Sujalshadow11/R-AV-Line-Follower-Robot/README.md

# R&AV LINE FOLLOWER ROBOT

> A High-Performance, Memory-Enabled, Path-Optimizing Autonomous Robotics Platform

---

# Overview

This repository documents my three-year engineering journey in designing and developing advanced Line Following Robots (LFRs), beginning from a simple beginner-level robot and evolving into a fully modular, memory-enabled, shortest-path-optimizing autonomous navigation platform.

The project progressively expanded across multiple engineering domains including:

- Embedded Systems
- PID Control Systems
- Autonomous Navigation
- Sensor Engineering
- PCB Design
- Runtime Configurable Interfaces
- EEPROM-Based Memory Systems
- High-Speed Robotics
- Custom Sensor Array Development

---

# Development Timeline

### YEAR 1 — Foundations of Reactive Robotics

- Basic IF-ELSE line following
- Sensor expansion experiments
- Mechanical calibration systems
- Drive system optimization

### YEAR 2 — Precision Control & Embedded Systems

- PID-based motion control
- Custom PCB development
- High-speed navigation
- Hybrid sensor architectures
- Competition-oriented optimization

### YEAR 3 — Intelligent Autonomous Robotics

- Teensy 4.1 migration
- Runtime configurable OLED interface
- EEPROM-based profile storage
- Shortest path optimization
- Fully custom sensor array development
- Autonomous path memory systems

---

## Repository Structure

```text
DOCS/
├── Year1.md
├── Year2.md
└── Year3.md

CODE/
├── EEPROM_print_for_shortest_path.ino
├── First_Prototype_Robot_Code.ino
├── IIT_Bombay_Code_Edit.ino
├── OLED_TEENSY.ino
├── SHORTEST_PATH.ino
├── Technoxian_Code_Edit.ino
├── UI.ino
└── Update_Logic_for_turns.ino

PCB/
├── Arduino_Nano_Carrier+Chassis_PCB
├── Teensy4.1_Carrier_Module_PCB
└── 10-Channel_Analog_IR_Sensor_Array_PCB

IMAGES/
├── Year1
├── Year2
└── Year3

VIDEOS/
├── Year1_Vid_Links
├── Year2_Vid_Links
├── Year3_Vid_Links
└── Full_Playlist_Link
```

---

## Documentation

- [Year 1 Development Journey (Click here)](DOCS/Year1.md)
- [Year 2 Development Journey (Click here)](DOCS/Year2.md)
- [Year 3 Development Journey (Click here)](DOCS/Year3.md)

---

## Key Features

- High-speed PID line following
- EEPROM-based runtime configuration
- OLED-based tuning interface
- Multi-profile PID storage system
- Custom TCRT5000L analog sensor array
- Adaptive sensor calibration architecture
- Shortest-path autonomous navigation
- Fully modular PCB-based system architecture

---

## Technologies Used

- Teensy 4.1
- Arduino Nano
- TB6612FNG Motor Driver
- QRE1113 Sensors
- TCRT5000L Sensors
- EasyEDA
- EEPROM Memory Systems
- PID Control Algorithms
- Embedded C/C++

---

## Demonstration Videos

Project demonstration videos and testing footage will be available through YouTube playlists.

- [Year 1 Progression Videos (Click here)](VIDEOS/Year1_Vid_Links.md)
- [Year 2 Progression Videos (Click here)](VIDEOS/Year2_Vid_Links.md)
- [Year 3 Progression Videos (Click here)](VIDEOS/Year3_Vid_Links.md)
- [Full Playlist (Click here)](VIDEOS/Full_Playlist_Link.md)

---

# Project Assets

## PCB Design Files
- [Arduino Nano Carrier PCB](PCB/LFR.zip)
- [Teensy 4.1 Carrier Module PCB](PCB/Array_PCB.zip)
- [10-Channel Analog IR Sensor Array](PCB/Teensy_Carrier_Module_PCB.zip)

## Source Code
- [Robot Source Codes](CODE)

## Media Resources
- [Development Images](IMAGES)
- [Video Archive](VIDEOS)

---

# Author

### **Sujal Chauhan |** [***Profile***](https://github.com/Sujalshadow11) <br>
Robotics / Embedded Systems / Autonomous Navigation / PCB Designer

# Team Members
### **Mustafa Raja |** [***Profile***](https://github.com/Raja-Mustafa) <br>
Robotics / Coding Expert / Control Systems <br>
<br>

### **Juned Ghanchi |** [***Profile***](https://github.com/juned-2005) <br>
Electronics / Robot Design / Logic Building <br>
<br>

### **Moksha Shah |** [***Profile***](https://github.com/MokshaShah-24) <br>
Autonomous navigation / Robotics and Embedded System / Coding / PCB Design <br>
<br>

### **Sneha Gohel |** [***Profile***](https://github.com/snehagohel631-ctrl) <br>
Electronics / Robotics Development / System Debugging / Embedded Designing <br>
<br>

### **Alok Singh |** [***Profile***](https://github.com/AlokSingh2006) <br>
Robotics Hardware / Mechanical Design / Product Development/ Mechanical Assembly <br>
<br>

### **Ritesh Swain |** [***Profile***](https://github.com/masterstone666) <br>
Robot Design/Electronics <br>
<br>

### **Om Sikligar |** [***Profile***](https://github.com/mistryom2912) <br>
Mechanical Design (Solidworks) / Hardware / Mechanical Assembly /Product Development<br>
<br>
