Sujalshadow11/R-AV-Line-Follower-Robot/VIDEOS/Full_Playlist_Link.md

[← Main Repository](../README.md)

 Youtube Playlist Link

### 🎥[Advanced Line Follower Robot Development Journey Clips](https://www.youtube.com/playlist?list=PLXy9W0wi6mShxHbvGi2lYo0ejLqUDOKU0)

---

# All Links

#### 🎥[Prototype Run](https://youtube.com/shorts/G9jCbpRqdrw?feature=share) <br>
#### 🎥[Slow Motion Video Demonstration](https://youtu.be/9cnTpXSCFiw) <br>
#### 🎥[Watch Competition Video at ITM Illuminati 2024](https://youtu.be/2ZwEChPN6mk) <br>
#### 🎥[Watch Competition Preparation Video for Ahmedabad University Ingenium 2024](https://youtu.be/NP2wJxn7rvI) <br>
<br>

#### 🎥[Zero Board Prototype Run](https://youtube.com/shorts/TxBQM8avwMc?feature=share) <br>
#### 🎥[SVNIT Competition Run](https://youtube.com/shorts/0UcYGhhQcCk?feature=share) <br>
#### 🎥[Technoxian Competition Abstract](https://youtube.com/shorts/DxRt9Ad0ADs?feature=share) <br>
#### 🎥[PCB Robot First Run](https://youtube.com/shorts/XTIpc-7uPW8?feature=share) <br>
#### 🎥[Slim Lipo Battery On-Board Charging](https://youtube.com/shorts/rOE8SAeBYEY?feature=share) <br>
#### 🎥[Full Run at Nirma University](https://youtu.be/AxtIyTeG06o) <br>
#### 🎥[Hybrid Sensor System](https://youtu.be/cHDWOMArfoY) <br>
<br>

#### 🎥[New Robot Design CAD Designing](https://youtu.be/8GJ0qbsseVE) <br>
#### 🎥[FULL On-board UI Designing](https://youtu.be/5oN1zwH2pbs) <br>
#### 🎥[Full Robot Run using Inhouse parts](https://youtu.be/NfQx6Jn7YF0) <br>

---
