Sujalshadow11/R-AV-Line-Follower-Robot/VIDEOS/Year3_Vid_Links.md

[← Year 2](Year2_Vid_Links.md) | [Main Repository](../README.md)

# Year 3 Progression Links

### 🎥[New Robot Design CAD Designing](https://youtu.be/8GJ0qbsseVE) <br>
### 🎥[FULL On-board UI Designing](https://youtu.be/5oN1zwH2pbs) <br>
### 🎥[Full Robot Run using Inhouse parts](https://youtu.be/NfQx6Jn7YF0) <br>

---
