Sujalshadow11/R-AV-Line-Follower-Robot/IMAGES/Year3/22.jpg

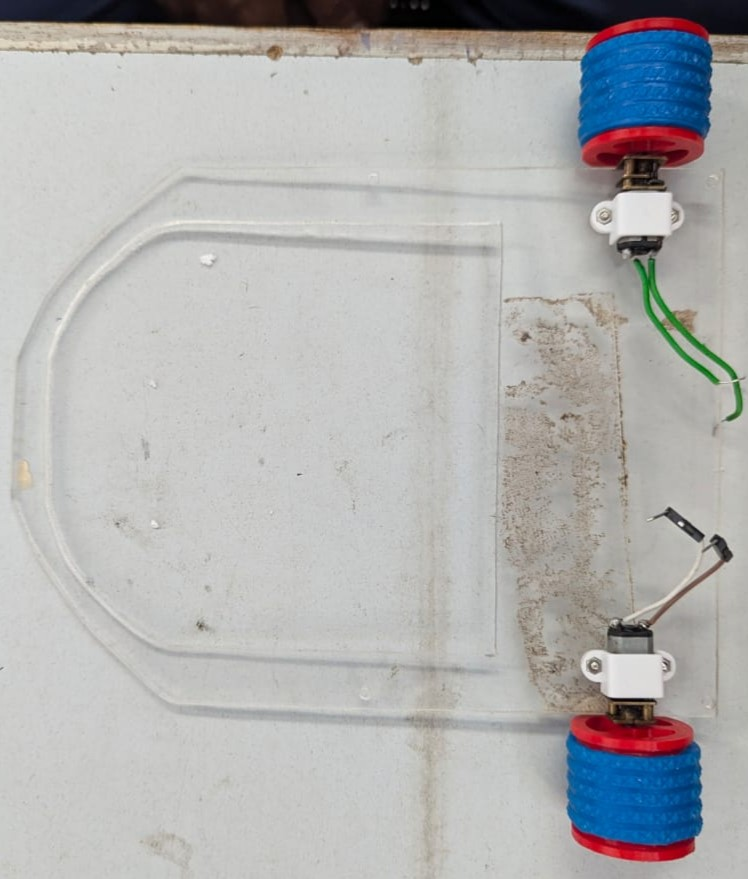
IMAGES/Year3/22.jpg
