Sujalshadow11/R-AV-Line-Follower-Robot/IMAGES/Year3/39.jpeg

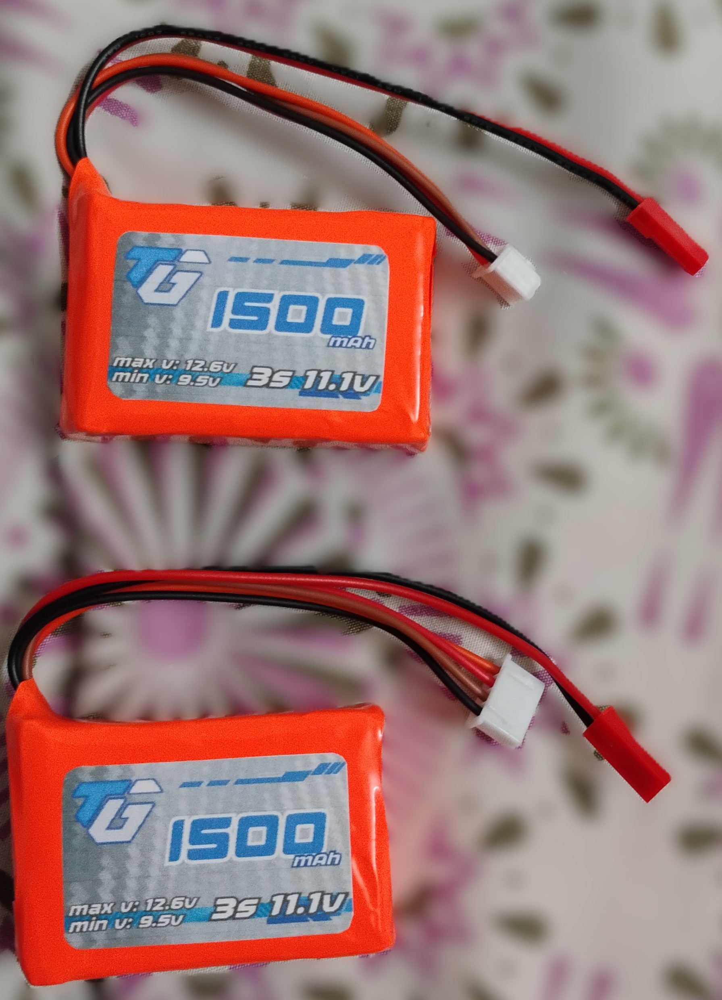
IMAGES/Year3/39.jpeg
