Sujalshadow11/R-AV-Line-Follower-Robot/CODE/OLED_TEENSY.ino

/*********************************************************************
  This is an example for getting started using the Teensy 3.6
  in the Arduino development environment.

  This sketch uses code taken from an Arduino Uno sketch to control
  the 128x64 OLED display over I2C for seamless transfer to Teensy.

  PWM LED brightness control is implemented using PWM output,
  partially controlled by a potentiometer on an analog input to show
  some of the basic Arduino functionality being used on Teensy.

  This example requires the SSD1306 display driver by Adafruit:
  https://github.com/adafruit/Adafruit_SSD1306

*********************************************************************/

#include <Wire.h>
#include <Adafruit_SSD1306.h>

#define OLED_RESET 4
Adafruit_SSD1306 display(OLED_RESET);

// make sure the SSD1306 driver is configured for 64 line height
#if (SSD1306_LCDHEIGHT != 64)
// #error("Height incorrect, please fix Adafruit_SSD1306.h!");
#endif

static const unsigned char PROGMEM image_EviSmile2_bits[] = {0x00,0x00,0x00,0x70,0x03,0x80,0xe0,0x01,0xc0,0xf3,0xf3,0xc0,0xff,0xff,0xc0,0xff,0xff,0xc0,0x7f,0xff,0x80,0x7f,0xff,0x80,0x7f,0xff,0x80,0xe7,0xf9,0xc0,0xe3,0xf1,0xc0,0xe1,0xe1,0xc0,0xf1,0xe3,0xc0,0xff,0xff,0xc0,0xff,0xff,0xc0,0x73,0x33,0x80,0x79,0x27,0x80,0x3c,0x0f,0x00,0x1f,0xfe,0x00,0x0f,0xfc,0x00,0x03,0xf0,0x00};

static const unsigned char PROGMEM image_battery_full_2_bits[] = {0x00,0x00,0x00,0x0f,0xff,0xfe,0x10,0x00,0x01,0x15,0x55,0x55,0x71,0x55,0x55,0x85,0x55,0x55,0x81,0x55,0x55,0x85,0x55,0x55,0x81,0x55,0x55,0x85,0x55,0x55,0x71,0x55,0x55,0x15,0x55,0x55,0x10,0x00,0x01,0x0f,0xff,0xfe,0x00,0x00,0x00,0x00,0x00,0x00};

void setup()   {
  // initialize OLED display
  display.begin(SSD1306_SWITCHCAPVCC, 0x3C);
  display.setTextColor(WHITE);
  display.clearDisplay();
  display.display();
}


void loop() {
display.clearDisplay();
display.drawBitmap(54, 8, image_battery_full_2_bits, 24, 16, 1);
display.display();
}
