Sujalshadow11/R-AV-Line-Follower-Robot/(commit log)

2026-05-15 Navigation buttons added to docs
2026-05-16 pcb gerber files
